Bulat-Mukhametdinov/STM-boy/hardware/mechanical/README.md

# Mechanical and 3D Files

Put STM-boy mechanical files in this directory.

## Recommended Files

| File | Purpose |
| --- | --- |
| `stm-boy-v0.1-pcb.step` | Board model for CAD inspection. |
| `stm-boy-v0.1-pcb-with-signal.step` | Board model with signal layer. |
| `stm-boy-v0.1-front-panel.dxf` | Laser-cut acrylic/front-panel outline. (ToDo)|
| `stm-boy-v0.1-rear-spacer.stl` | Printable spacer or rear mechanical part. (ToDo) |
| `stm-boy-v0.1-dimensions.pdf` | Human-readable dimension drawing. (ToDo) |

## Notes to Record

- PCB thickness.
- Acrylic/front-panel thickness.
- Spacer or standoff height.
- Screw type, thread, and length.
- Battery dimensions and mounting method.
- Display clearance and viewing-window dimensions.
- Speaker clearance and acoustic opening.
- Any insulation needed near the LiPo battery or exposed pads.
