Bulat-Mukhametdinov/STM-boy/hardware/breadboard/example.gif

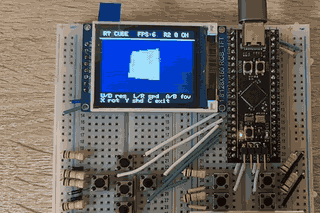
hardware/breadboard/example.gif
