Bulat-Mukhametdinov/STM-boy/hardware/pcb/schematics.pdf

STM32F411CEU6 MCU | W25Q128JVPIQ 16Mb External FLASH

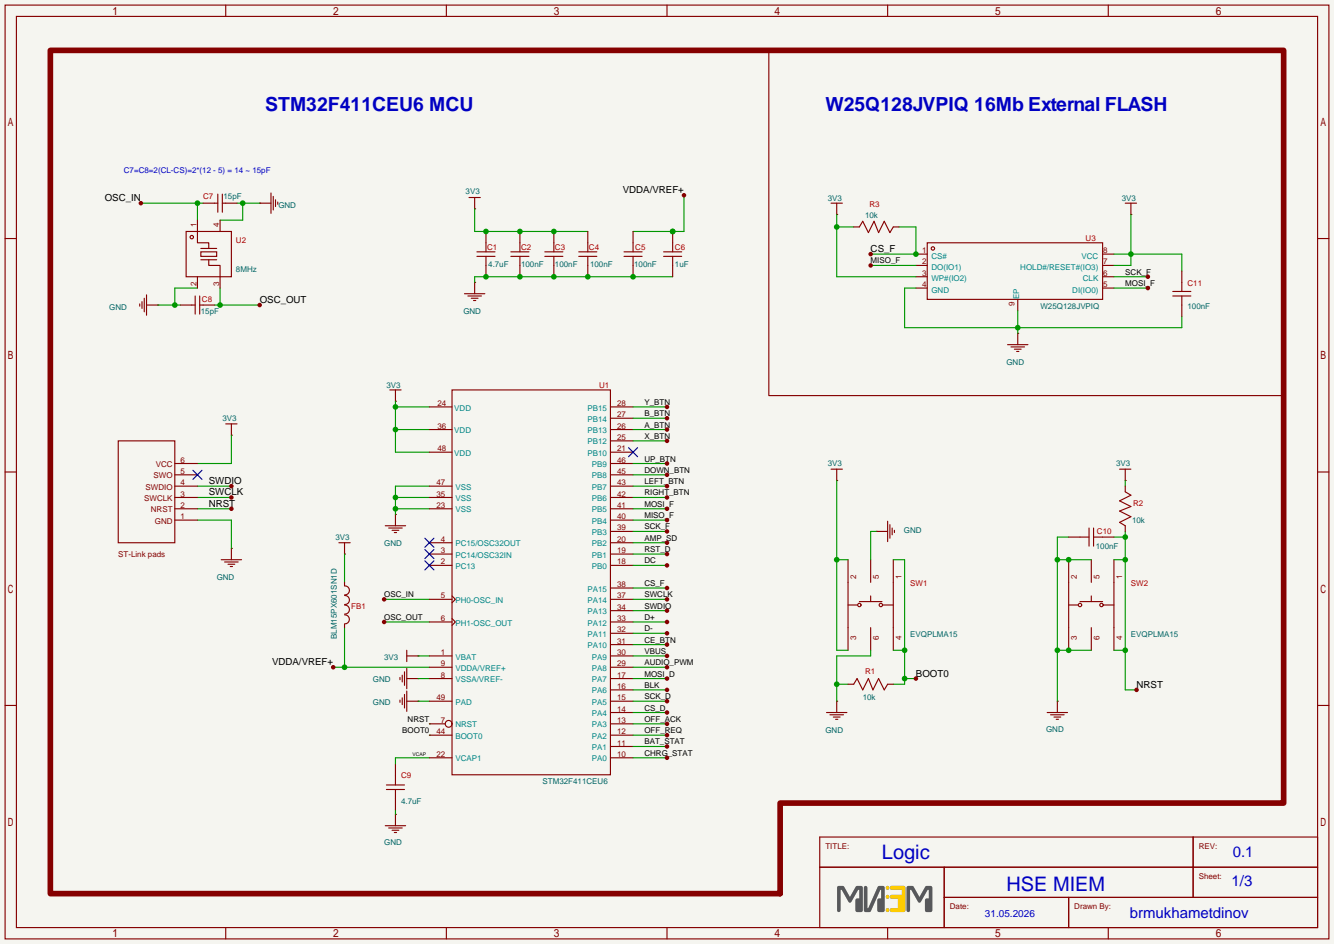
[picture p3: page 1]

TITLE: Logic | REV: 0.1

HSE MIEM | Sheet:

Date: 31.05.2026 | Drawn By: brmukhametdinov

# POWER-PATH CHARGER BQ24075

# TYPE-C CONNECTOR

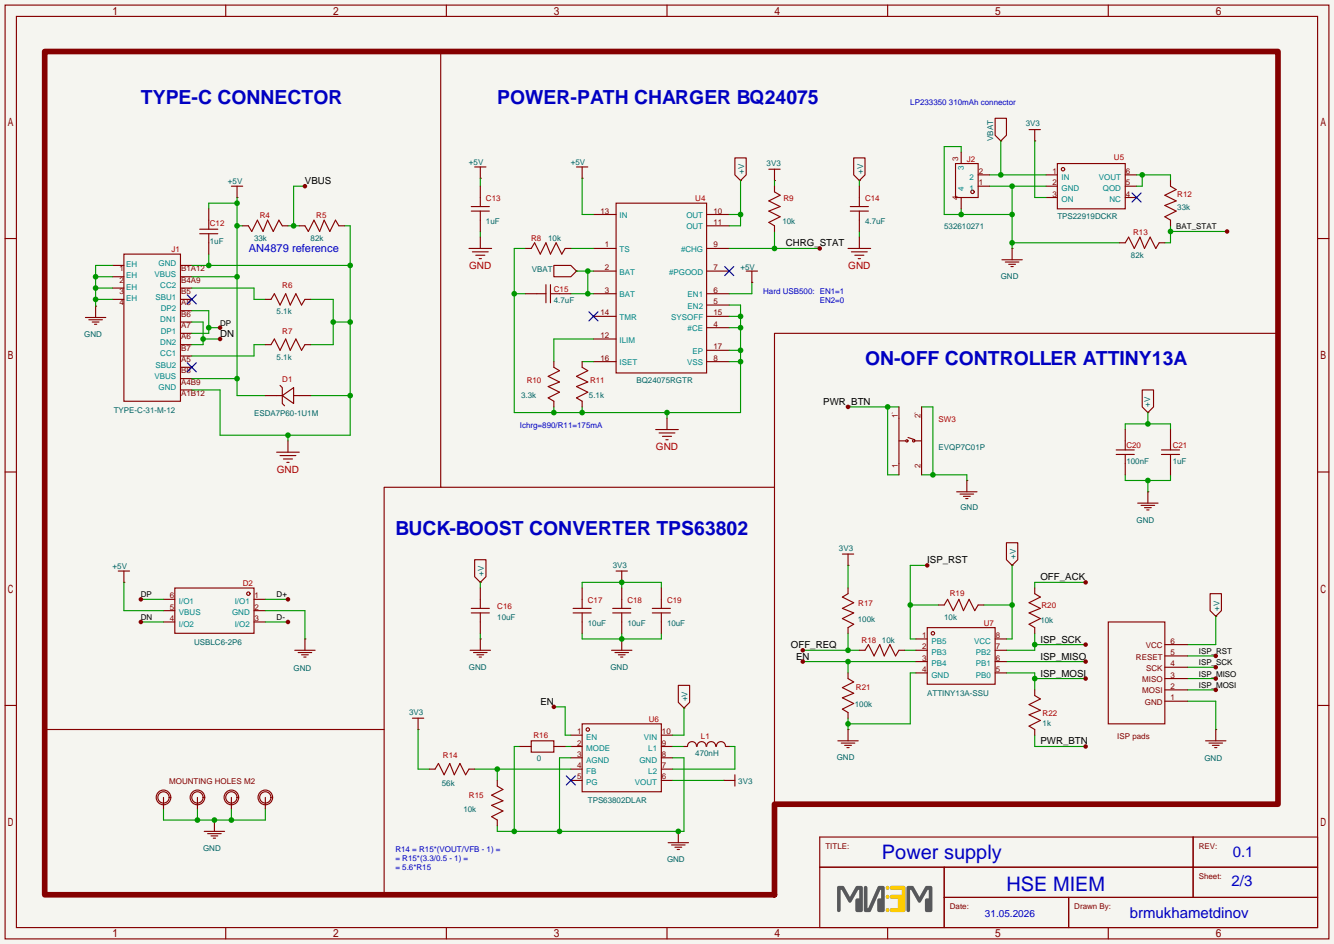
[picture p4: page 2]

# RIGHT Button Block

# PAM8302AASCR AMPLIFIER

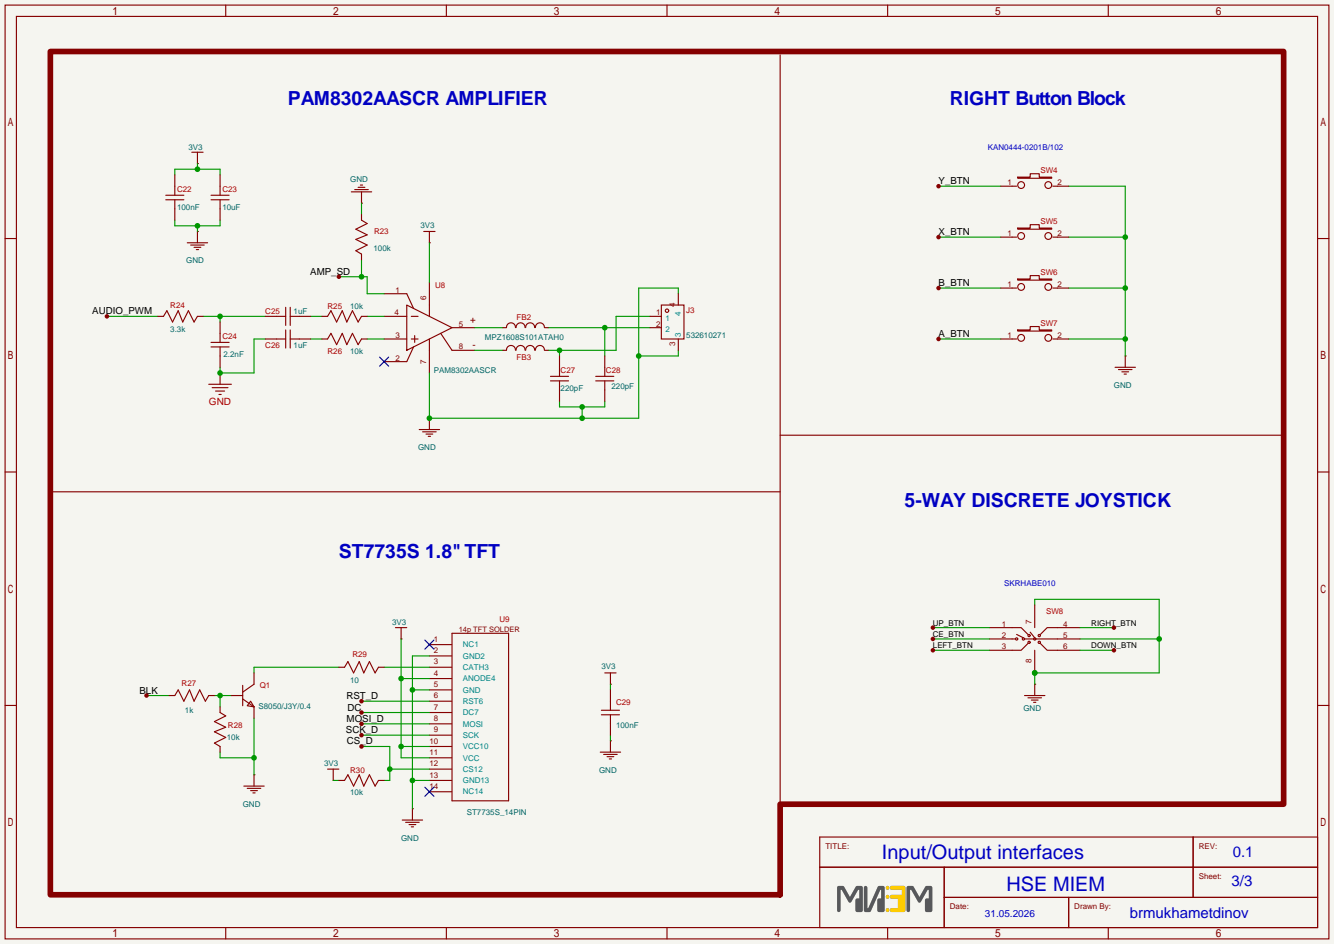
[picture p5: page 3]

VCC10 10
VCC 11
