Bulat-Mukhametdinov/STM-boy/hardware/pcb/pcb.pdf

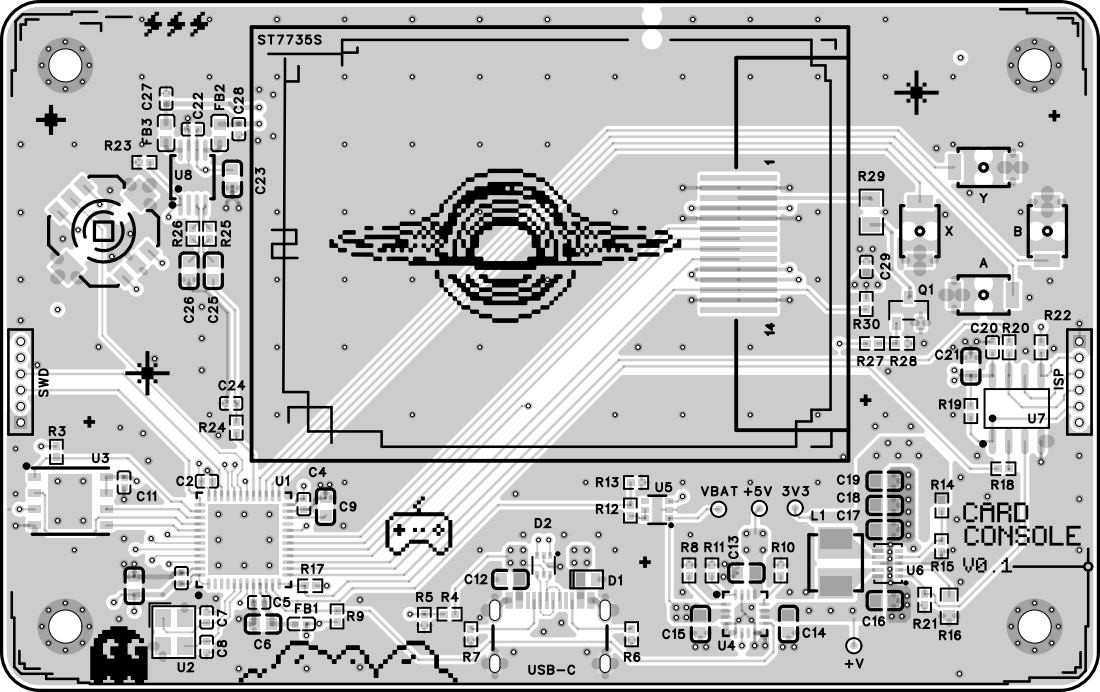
[picture p6: page 1]

# SPEAKER

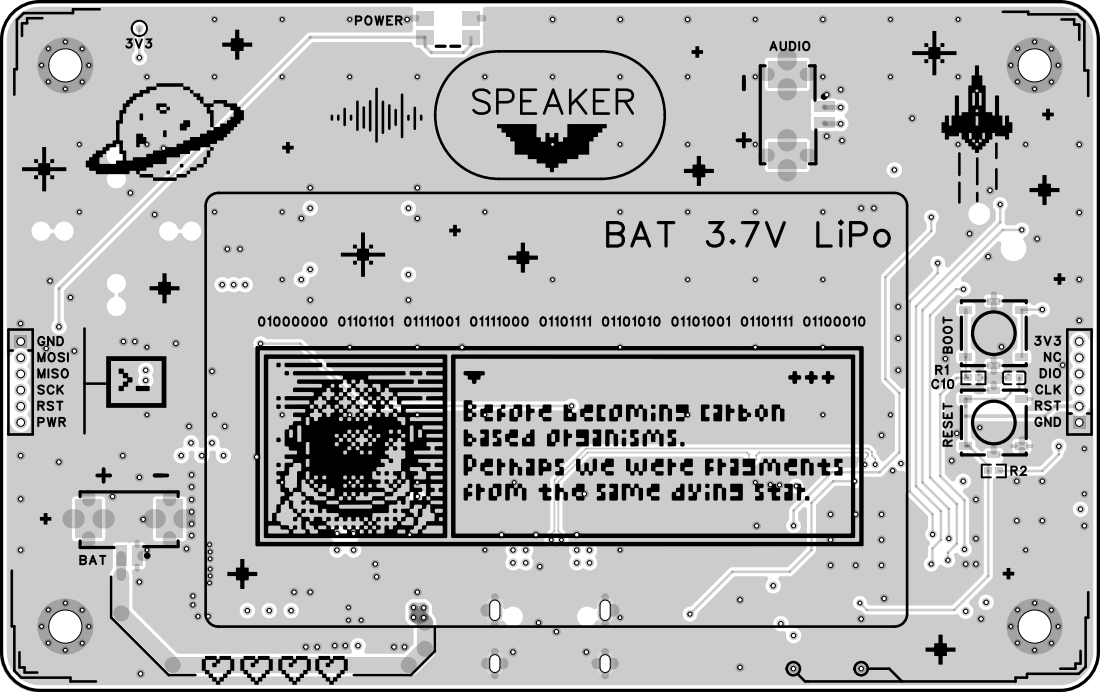
[picture p7: page 2]
