Bulat-Mukhametdinov/STM-boy/(list of files, drawings)

Other design files:
hardware/pcb/stm_boy_proj.epro
