Bulat-Mukhametdinov/STM-boy/software/stm32-retroport/Core/Src/audio_assets.c

#include "audio_assets.h"

#include <stddef.h>

#define PCM_CLIP(samples_) \
    { (samples_), (uint32_t)(sizeof(samples_) / sizeof((samples_)[0])) }

static const uint8_t audio_sound_nav[] = {
    128, 169, 191, 184, 152, 108,  74,  65,  84, 124, 165, 189, 185, 155, 112,  78,
     66,  83, 120, 161, 186, 185, 157, 117,  81,  68,  82, 117, 157, 184, 185, 160,
    121,  85,  69,  81, 113, 153, 181, 184, 162, 124,  89,  71,  80, 110, 149, 178,
    183, 164, 128,  92,  73,  79, 108, 145, 174, 182, 165, 131,  96,  76,  79, 105
};

static const uint8_t audio_sound_select[] = {
    128, 192, 193, 130,  65,  62, 123, 189, 195, 135,  68,  61, 119, 186, 196, 139,
     72,  60, 114, 182, 197, 144,  75,  59, 110, 179, 197, 148,  79,  59, 106, 175,
    197, 152,  83,  59, 102, 171, 197, 156,  87,  59,  98, 167, 197, 159,  91,  59,
     95, 163, 196, 163,  95,  60,  92, 159, 195, 166,  99,  61,  89, 155, 194, 169,
    104,  63,  86, 150, 193, 171, 108,  64,  83, 146, 191, 174, 112,  66,  81, 142
};

static const uint8_t audio_sound_back[] = {
    128, 152, 172, 188, 196, 197, 189, 174, 153, 130, 107,  86,  70,  61,  60,  67,
     81, 101, 124, 147, 168, 184, 193, 195, 189, 175, 156, 134, 111,  91,  74,  65,
     62,  68,  80,  98, 120, 142, 163, 179, 190, 193, 188, 176, 159, 138, 116,  95,
     79,  68,  64,  68,  79,  96, 116, 138, 158, 175, 186, 191, 187, 177, 161, 142,
    120, 100,  83,  71,  67,  69,  78,  94, 113, 134, 154, 171, 183, 188, 186, 178
};

static const uint8_t audio_sound_reset[] = {
    128, 163, 188, 198, 189, 164, 130,  96,  69,  59,  66,  90, 124, 158, 185, 197,
    190, 167, 134, 100,  73,  60,  65,  87, 119, 154, 182, 195, 191, 170, 139, 104,
     76,  62,  65,  84, 115, 150, 178, 194, 192, 173, 143, 108,  80,  63,  64,  82,
    112, 145, 175, 192, 192, 175, 146, 113,  83,  65,  64,  80, 108, 141, 171, 189,
    192, 177, 150, 117,  87,  68,  64,  78, 104, 137, 167, 187, 191, 179, 153, 121,
     91,  70,  65,  76, 101, 133, 164, 185, 191, 181, 157, 125,  94,  73,  66,  75
};

static const AudioPcmClip audio_sounds[AUDIO_SOUND_COUNT] = {
    [AUDIO_SOUND_NAV] = PCM_CLIP(audio_sound_nav),
    [AUDIO_SOUND_SELECT] = PCM_CLIP(audio_sound_select),
    [AUDIO_SOUND_BACK] = PCM_CLIP(audio_sound_back),
    [AUDIO_SOUND_RESET] = PCM_CLIP(audio_sound_reset),
};

const AudioPcmClip *AudioAssets_GetSound(AudioSoundId sound)
{
    if ((uint32_t)sound >= (uint32_t)AUDIO_SOUND_COUNT) {
        return NULL;
    }

    return &audio_sounds[sound];
}
