Bulat-Mukhametdinov/STM-boy/software/stm32-retroport/tools/screen_render/ppm_to_png.py

#!/usr/bin/env python3
"""Convert a binary PPM (P6) to PNG using only the standard library."""
import struct
import sys
import zlib


def read_ppm(path):
    with open(path, "rb") as f:
        data = f.read()
    if not data.startswith(b"P6"):
        raise ValueError("not a P6 PPM")
    # Parse header: P6 <w> <h> <maxval>, whitespace-separated, then one byte.
    idx = 2
    fields = []
    while len(fields) < 3:
        while idx < len(data) and data[idx] in b" \t\r\n":
            idx += 1
        if idx < len(data) and data[idx:idx + 1] == b"#":
            while idx < len(data) and data[idx] not in b"\r\n":
                idx += 1
            continue
        start = idx
        while idx < len(data) and data[idx] not in b" \t\r\n":
            idx += 1
        fields.append(int(data[start:idx]))
    w, h, _maxval = fields
    idx += 1  # single whitespace after maxval
    return w, h, data[idx:idx + w * h * 3]


def write_png(path, w, h, rgb):
    def chunk(tag, payload):
        c = tag + payload
        return struct.pack(">I", len(payload)) + c + struct.pack(">I", zlib.crc32(c) & 0xFFFFFFFF)

    raw = bytearray()
    stride = w * 3
    for y in range(h):
        raw.append(0)  # filter type 0
        raw.extend(rgb[y * stride:(y + 1) * stride])

    sig = b"\x89PNG\r\n\x1a\n"
    ihdr = struct.pack(">IIBBBBB", w, h, 8, 2, 0, 0, 0)  # 8-bit RGB
    with open(path, "wb") as f:
        f.write(sig)
        f.write(chunk(b"IHDR", ihdr))
        f.write(chunk(b"IDAT", zlib.compress(bytes(raw), 9)))
        f.write(chunk(b"IEND", b""))


def main():
    if len(sys.argv) != 3:
        print("usage: ppm_to_png.py <in.ppm> <out.png>", file=sys.stderr)
        sys.exit(1)
    w, h, rgb = read_ppm(sys.argv[1])
    write_png(sys.argv[2], w, h, rgb)


if __name__ == "__main__":
    main()
