Bulat-Mukhametdinov/STM-boy/(commit log)

2026-05-29 Include PCB design image in README
    Add PCB design image to README
2026-05-31 version 0.1
    [BOM.csv, BOM_stm_boy.xlsx, stm_boy_proj.epro]
2026-06-03 stencil update in gerber
2026-06-06 gerber fix
2026-08-02 stm32 firmware bring up
2026-08-02 schematics update
