Bulat-Mukhametdinov/STM-boy/(notices)

Notices in the files:
software/stm32-retroport/Core/Src/main.cpp:
Copyright (c) 2026 STMicroelectronics.
All rights reserved.
This software is licensed under terms that can be found in the LICENSE file
